planeturban/ubeswitch/README.md

## 301
Needed to keep it clean. BOM and other stuff is over here -> https://github.com/planeturban/ubeswitchmk6
