planeturban/ubeswitch/images/mkvi.png

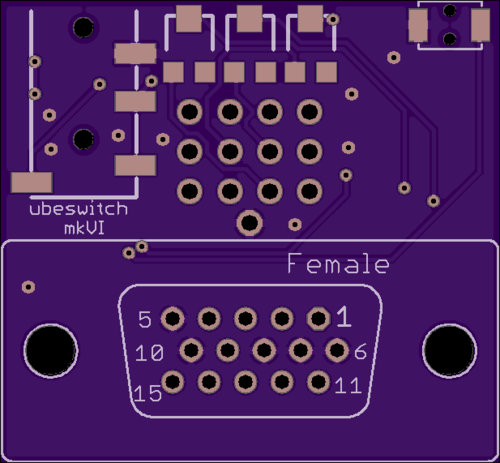
images/mkvi.png
