planeturban/ubeswitch/images/top.png

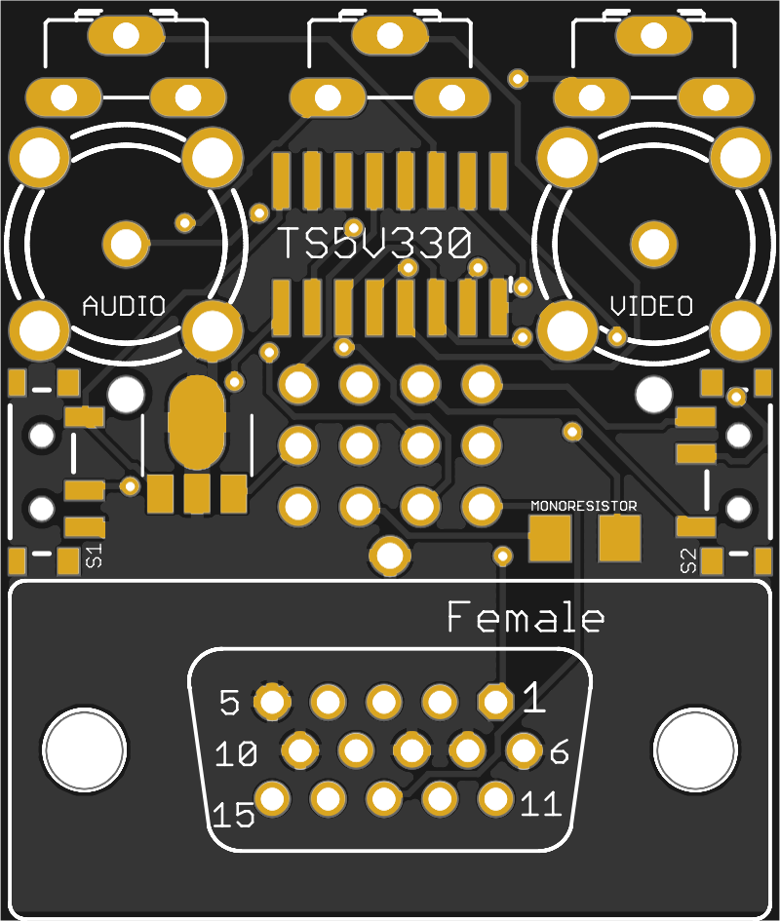
images/top.png
