planeturban/ubeswitch/mk6/mk6.brd

## EAGLE design mk6/mk6.brd (2017-08-16)

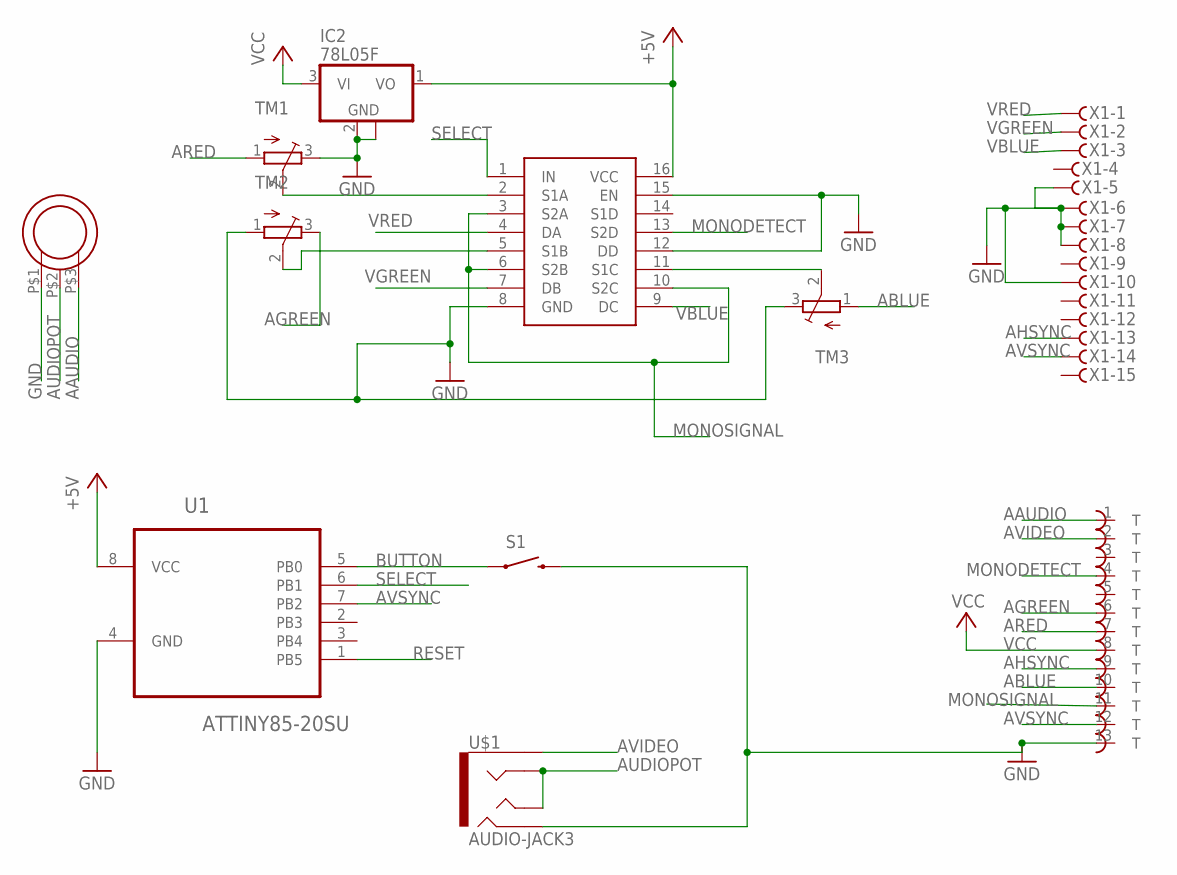
[picture p3: schematic mk6.sch]

Parts:
ATARIOUT: DIN13T; ADADS
IC2: 78L05F; SOT89
S1: SWITCH-MOMENTARY-2TACTILE-SWITCH-SMD-RIGHT-ANGLE; TACTILE_SWITCH-SMD-RIGHT-ANGLE
TM1, TM2, TM3: TRIMPOTTC33X; TC33X
TS5V330: V330; SOIC16N
U1: ATTINY85-20SU; SOIC127P798X216-8N
U$1: AUDIO-JACK3; AUDIO-JACK-TRRS-SMD
U$2: DB-1001N; THUMB_POT
X1: F15HDVS; HDF15V

Connections:
+5V: IC2.1 (VO), TS5V330.16 (VCC), U1.8 (VCC)
AAUDIO: ATARIOUT.1, U$2.P$3 (3)
ABLUE: ATARIOUT.10, TM3.1 (A)
AGREEN: ATARIOUT.6, TM2.3 (E)
AHSYNC: ATARIOUT.9, X1.13
ARED: ATARIOUT.7, TM1.1 (A)
AUDIOPOT: U$1.RING1, U$1.TIP, U$2.P$2 (2)
AVIDEO: ATARIOUT.2, U$1.EARTH
AVSYNC: ATARIOUT.12, U1.7 (PB2), X1.14
BUTTON: S1.1, U1.5 (PB0)
GND: ATARIOUT.13, IC2.2 (GND), IC2.2@1 (GND), S1.2, TM1.3 (E), TM2.1 (A), TM3.3 (E), TS5V330.8 (GND), TS5V330.12 (DD), TS5V330.15 (EN), U1.4 (GND), U$1.RING2, U$2.P$1 (1), X1.5, X1.6, X1.7, X1.8, X1.10
MONODETECT: ATARIOUT.4, TS5V330.13 (S2D)
MONOSIGNAL: ATARIOUT.11, TS5V330.3 (S2A), TS5V330.6 (S2B), TS5V330.10 (S2C)
unnamed: TM1.2 (S), TS5V330.2 (S1A)
unnamed: TM2.2 (S), TS5V330.5 (S1B)
unnamed: TM3.2 (S), TS5V330.11 (S1C)
RESET: U1.1 (PB5)
SELECT: TS5V330.1 (IN), U1.6 (PB1)
VBLUE: TS5V330.9 (DC), X1.3
VCC: ATARIOUT.8, IC2.3 (VI)
VGREEN: TS5V330.7 (DB), X1.2
VRED: TS5V330.4 (DA), X1.1

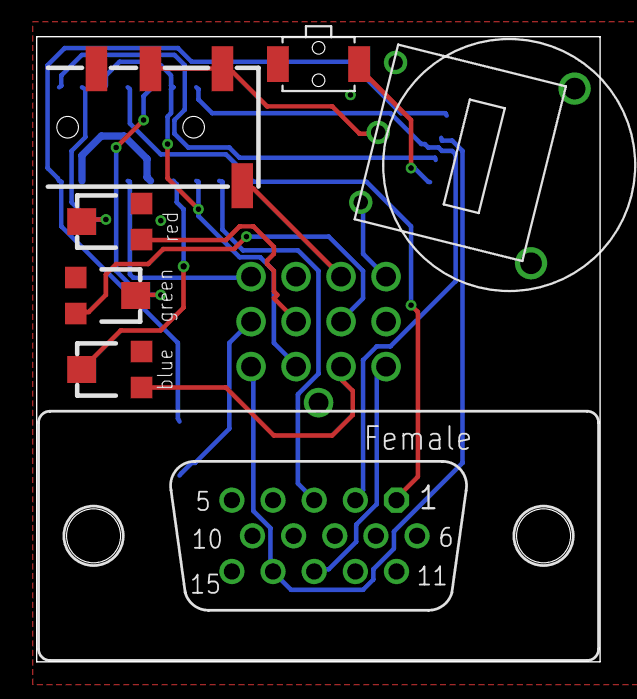
[picture p4: board mk6.brd from above]

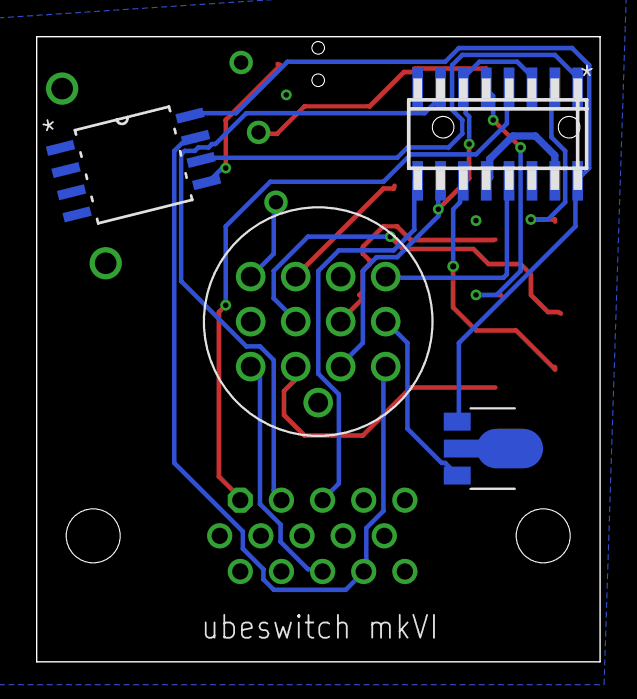
[picture p5: board mk6.brd from below]

Board: 2 copper layers, 31.3 x 34.7 mm, 11 parts (4 on the bottom side), 21 nets.
