planeturban/ubeswitch/breakout/breakout.brd

## EAGLE design breakout/breakout.brd (2017-05-27)

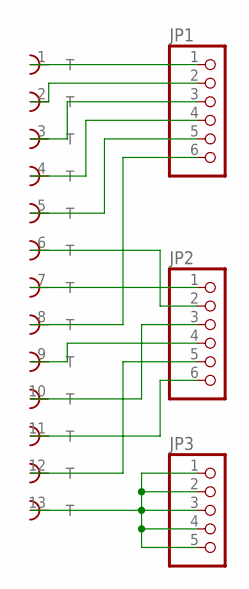
[picture p6: schematic breakout.sch]

Parts:
J1: DIN13T; ADADS
JP1, JP2: PINHD-1X6; 1X06
JP3: PINHD-1X5; 1X05

Connections:
GND: J1.13, JP3.1, JP3.2, JP3.3, JP3.4, JP3.5
unnamed: J1.1, JP1.1
unnamed: J1.2, JP1.2
unnamed: J1.3, JP1.3
unnamed: J1.4, JP1.4
unnamed: J1.5, JP1.5
unnamed: J1.7, JP2.1
unnamed: J1.6, JP2.2
unnamed: J1.8, JP1.6
unnamed: J1.10, JP2.3
unnamed: J1.11, JP2.6
unnamed: J1.9, JP2.4
unnamed: J1.12, JP2.5

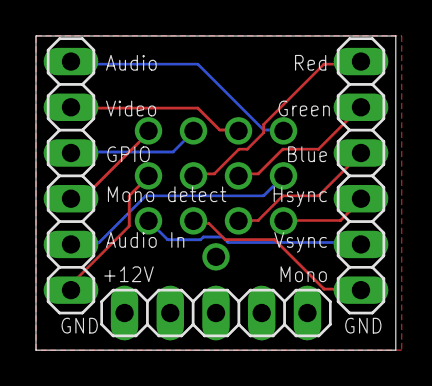
[picture p7: board breakout.brd from above]

Board: 2 copper layers, 20.0 x 17.5 mm, 4 parts (1 on the bottom side), 13 nets.
