planeturban/ubeswitch/mk5/SMD.brd

## EAGLE design mk5/SMD.brd (2017-04-13, an earlier design)

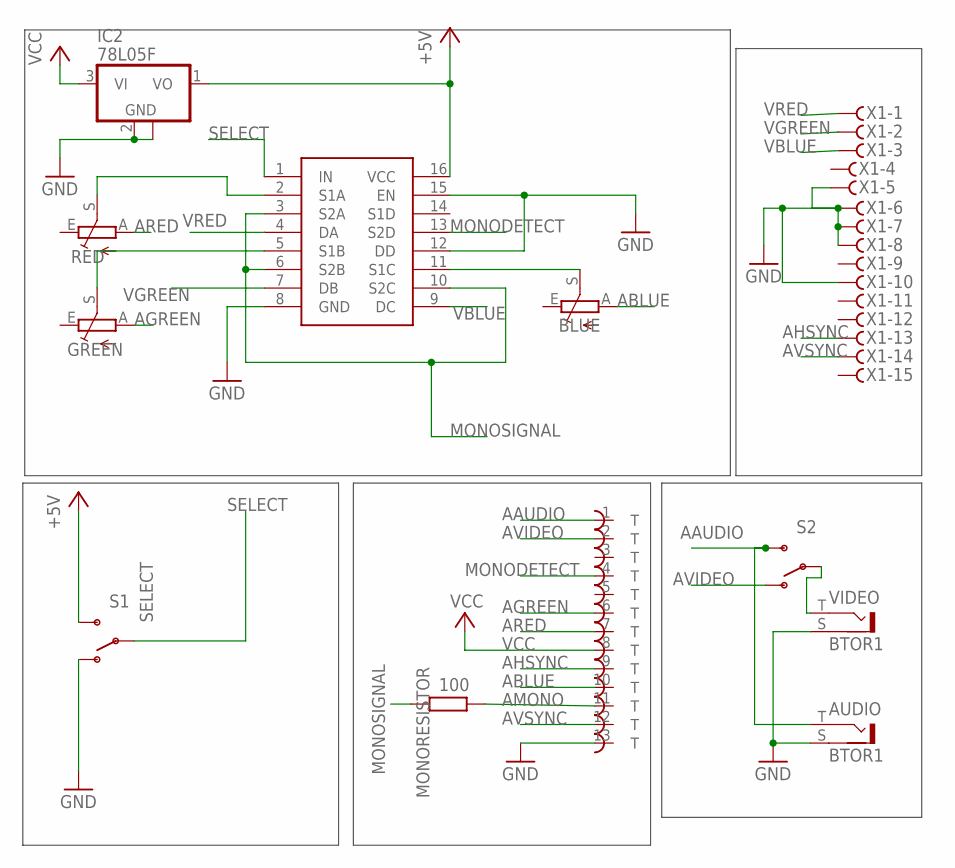
[picture p8: schematic SMD.sch]

Parts:
ATARIOUT: DIN13T; ADADS
AUDIO: BTOR1
BLUE: TRIM_EU-CA6H; CA6H
GREEN: TRIM_EU-CA6H; CA6H
IC2: 78L05F; SOT89
MONORESISTOR: 100; R1206
RED: TRIM_EU-CA6H; CA6H
S1, S2: SWITCH-SPDT-SMD-A; SWITCH-SPST-SMD-A
TS5V330: V330; SOIC16N
VIDEO: BTOR1
X1: F15HDVS; HDF15V

Connections:
+5V: IC2.1 (VO), S1.3 (S), TS5V330.16 (VCC)
A/V-PIN: S2.2, VIDEO.T (1)
AAUDIO: ATARIOUT.1, AUDIO.T (1), S2.3 (S)
ABLUE: ATARIOUT.10, BLUE.A
AGREEN: ATARIOUT.6, GREEN.A
AHSYNC: ATARIOUT.9, X1.13
AMONO: ATARIOUT.11, MONORESISTOR.2
ARED: ATARIOUT.7, RED.A
AVIDEO: ATARIOUT.2, S2.1 (O)
AVSYNC: ATARIOUT.12, X1.14
BOUT: BLUE.S, TS5V330.11 (S1C)
GND: ATARIOUT.13, AUDIO.S (2), IC2.2 (GND), IC2.2@1 (GND), S1.1 (O), TS5V330.8 (GND), TS5V330.12 (DD), TS5V330.15 (EN), VIDEO.S (2), X1.5, X1.6, X1.7, X1.8, X1.10
GOUT: GREEN.S, TS5V330.5 (S1B)
MONODETECT: ATARIOUT.4, TS5V330.13 (S2D)
MONOSIGNAL: MONORESISTOR.1, TS5V330.3 (S2A), TS5V330.6 (S2B), TS5V330.10 (S2C)
ROUT: RED.S, TS5V330.2 (S1A)
SELECT: S1.2, TS5V330.1 (IN)
VBLUE: TS5V330.9 (DC), X1.3
VCC: ATARIOUT.8, IC2.3 (VI)
VGREEN: TS5V330.7 (DB), X1.2
VRED: TS5V330.4 (DA), X1.1

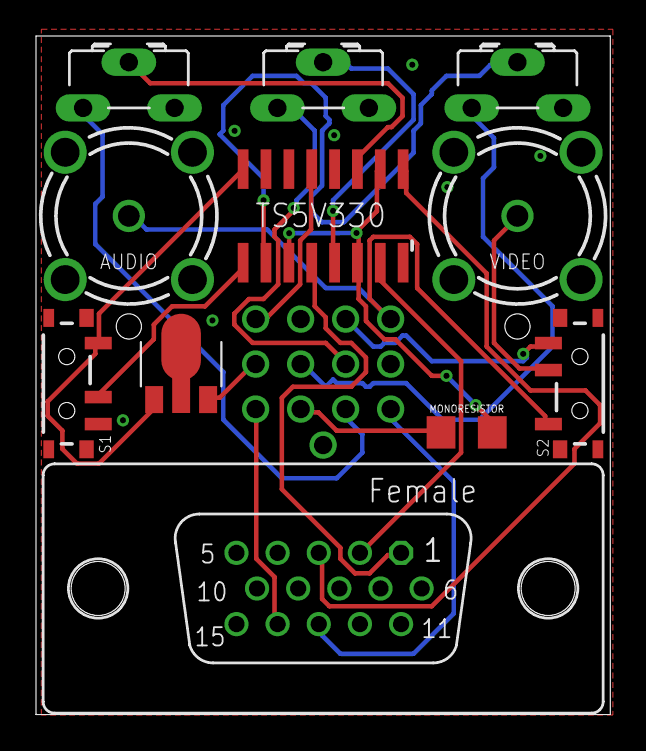
[picture p9: board SMD.brd from above]

Board: 2 copper layers, 31.9 x 37.7 mm, 12 parts (1 on the bottom side), 21 nets.
