planeturban/ubeswitch/mk2.5/mk2.5.brd

## EAGLE design mk2.5/mk2.5.brd (2016-09-30)

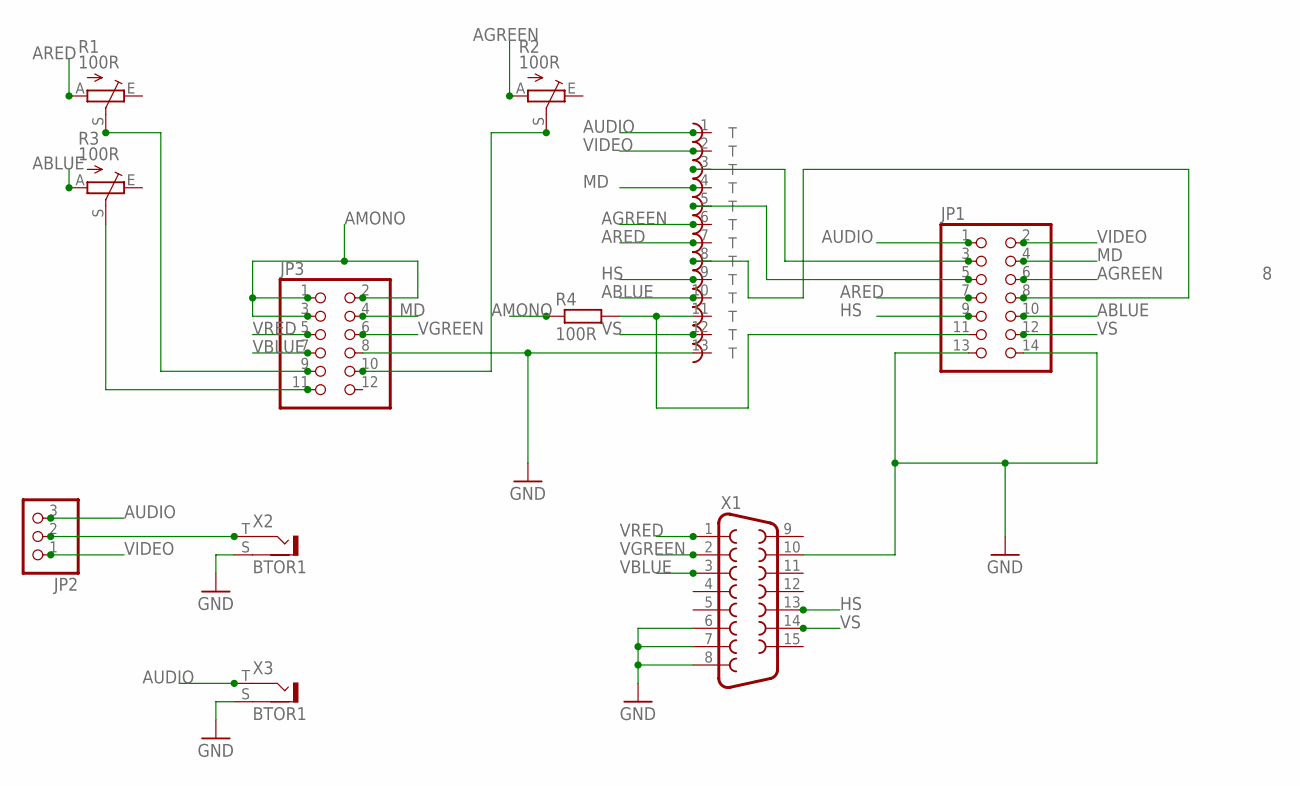
[picture p10: schematic mk2.5.sch]

Parts:
J1: DIN13T; ADADS
JP1: PINHD-2X7; 2X07
JP2: PINHD-1X3; 1X03
JP3: PINHD-2X6; 2X06
R1, R2, R3: 100R; CA6H
R4: 100R; 0204/5
X1: F15HDV; HDF15V
X2, X3: BTOR1

Connections:
8: J1.8, JP1.8
ABLUE: J1.10, JP1.10, R3.A
AGREEN: J1.6, JP1.6, R2.A
AMONO: JP3.1, JP3.2, JP3.3, R4.1
ARED: J1.7, JP1.7, R1.A
AUDIO: J1.1, JP1.1, JP2.3, X3.T (1)
GND: J1.13, JP1.13, JP1.14, JP3.8, X1.6, X1.7, X1.8, X1.10, X2.S (2), X3.S (2)
HS: J1.9, JP1.9, X1.13
MD: J1.4, JP1.4, JP3.4
unnamed: J1.11, JP1.11, R4.2
unnamed: JP3.9, R1.S
unnamed: JP3.10, R2.S
unnamed: JP2.2, X2.T (1)
unnamed: JP3.11, R3.S
unnamed: J1.3, JP1.3
unnamed: J1.5, JP1.5
VBLUE: JP3.7, X1.3
VGREEN: JP3.6, X1.2
VIDEO: J1.2, JP1.2, JP2.1
VRED: JP3.5, X1.1
VS: J1.12, JP1.12, X1.14

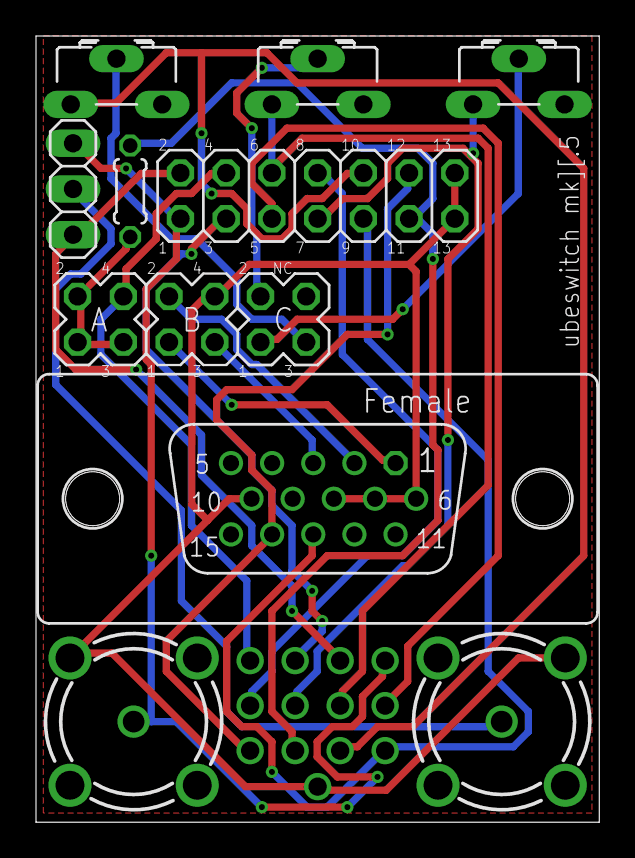
[picture p11: board mk2.5.brd from above]

Board: 2 copper layers, 31.3 x 43.7 mm, 11 parts (1 on the bottom side), 21 nets.
