planeturban/ubeswitch/(commit log)

2016-10-10 Added mk3, images, moved mk2.5
    [SMD.brd, SMD.sch, THT.brd, THT.sch, mk2.5.brd, mk2.5.sch]
2016-10-10 Changed base resistor to 1k.
    [SMD.brd, SMD.sch, THT.brd, THT.sch]
2016-10-11 Locked the connectors.
    [SMD.brd, THT.brd]
2016-10-12 Switched to CD4053, didn't check the ratings on the HC-one.
    [THT.brd, THT.sch]
2017-03-07 mk5. Whatever happened to mk4? Nobody knows.
    [SMD.brd, SMD.sch, THT.brd, THT.sch]
2017-03-07 No THT for you!
    [THT.brd, THT.sch]
2017-03-07 Removed obsolete mk3.
    [SMD.brd, SMD.sch, THT.brd, THT.sch]
2017-03-07 Added notes in partlist
    [SMD.brd]
2017-03-15 Swapped switch pins on A/V switch, to make it easier to patch video to video RCA.
    [SMD.brd, SMD.sch]
2017-04-13 Better placement of vias, to minimize risk of bridging.
    [SMD.brd]
2017-04-20 Breadout board.
    [breakout.brd, breakout.sch]
2017-04-22 Breakout, logical placement of the headers
    [breakout.brd]
2017-04-30 Why not group things together?
    [breakout.brd, breakout.sch]
2017-06-30 Version 5.1 Removed RCAs
    [SMD.brd, SMD.sch]
2017-06-30 BEtter placement of TS5V330
    [SMD.brd]
2017-08-10 code and stuff
    [mk6.brd, mk6.sch]
2017-08-10 Replaced RCAs for 3.5mm
    [SMD.brd, SMD.sch]
2017-08-15 Shorter switch time
2017-08-16 'Trying to do things properly often comes back to haunt you' - Exxos. Moved a via that could mess things up. Modified the footprint of the button to make it easier when soldering.
    [mk6.brd, mk6.sch]
